dltech/laminator-nemo/sch/heater_dir_ctrl.png

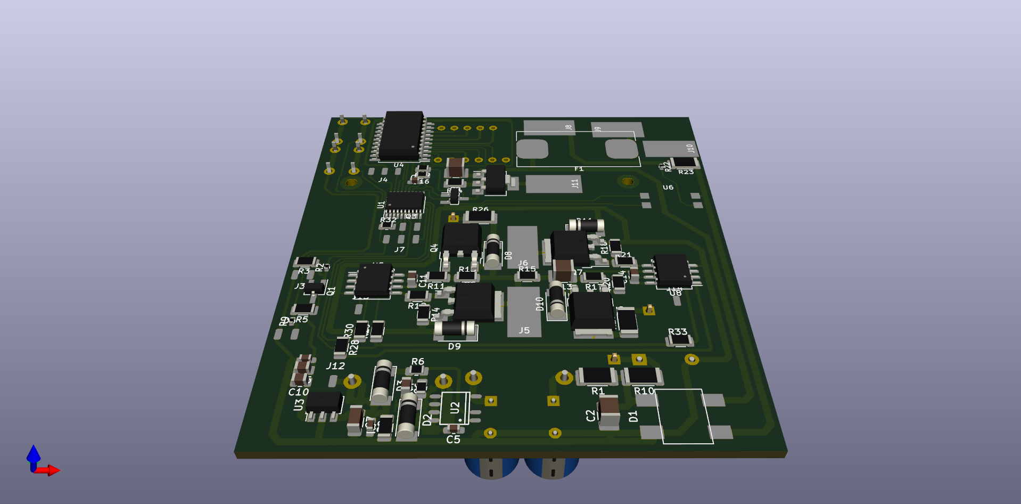
sch/heater_dir_ctrl.png
