dltech/laminator-nemo/README.md

# laminator-nemo
simple replacement board for office laminator with display, temperature and motor control.
