dltech/laminator-nemo/scenario.odt

Я как и многие другие электронщики не хочу себя ограничивать набором стандартных отладочных плат. И тут становится актуальным вопрос получения прототипов. В нашем веке совершенно любой прошаренный айтишник, может быть даже школьник, порывшись у себя в кармане найдет 20$ и закажет партию плат в китае. Да и вопросами они занимаются настолько опережающими время, что срок доставки конверта с платами в один два месяца почтой россии (почта китая отправляет пакет к нам обычно за неделю) для них не критичен. В то время как странноватые фрики вроде меня обсуждают на форумах вопрос, как бы так по культурнее перевести на иностранные языки типично любительский термин лазерно утюжная технология. Ну тут нет ничего плохого в том что ты оказался на днище технического прогресса, ведь всё можно прикрыть умным словом киберпанк, были бы хоть какие нибудь технологии. Причем мало кто знает что важно отличать киберпанк от посткиберпанка, в первом случае он самый, но еще средний, во втором уже полный. Ну тут не об этом, давайте подумаем, как же приблизить домашнее прототипирование ПП к заводскому? На заводах рисунок дорожек на плату переносится при помощи фоторезиста. А сам пленочный фоторезист плотно приклеивается при помощи валиков. Вот именно этот вопрос и будем решать в этом видео. Вот у меня есть сломанный ламинатор. По моему скромному мнению ему нужно заменить плату управления, да и родной двигатель утерян, но удачно подходят такие же от микроволновок. Наиболее полная плата управления должна включать термоконтроль, управление двигателем, замечать когда плата уже успела проехать и даже иметь какую то там индикацию для приличия. Вот так выглядит принципиальная схема платы, а вот так структурная. Термоконтроль это одно амперный планарный симистор ST и DS18B20й термодатчик. Управление двигателем мостом на двух амперных полевиках 2N60, ну вон те которые дайте кулечек транзисторов за 50, кто их произвел не знаю, но судя по маркировке это моторолла. Для того чтобы соединить их с контроллером пришлось поставить драйверы IR2103. Жаль что рассыпухой так просто этот вопрос не решишь, ровно как и не купишь по близости драйвер сразу на четыре транзистора. Раз TTL, два TTL и все как заверте.. Буферный повторитель перед симистором в моем случае это цифровой транзистор. Добавлять еще буферов, оптоизоляторов, стабилизаторов и согласователей уровней я не стал, потому что у меня все хорошо. Блок питания небезызвестный tinyswitch в бестрансформаторном варианте. Также добавлен еще один ключ для ультрафиолетовой лампы, как приедет добавлю, будет засвечивать строго по таймеру. Микроконтроллером по умолчанию для меня давно стал STM32, младшие их варианты одно время еще и стоили по 30р, почти как attiny. Сейчас сотка, ну терпимо, по прежнему сомневаюсь что кто то еще предложит дешевле Cortex M. Одни преимущества, прошивка по трем проводам, 48 мегагерц, 32 разряда (теперь можно спокойно объявлять int), жаль без плавающей точки, правда вот этому вот двух кнопочному оно зачем? Компилируется это все вместе со стандартными Си библиотеками чуть ли не полноценным gcc, как и под большую компьютеру, что очень удобно. Ну вот и мои 500 строчек, Ctrl-T, прописываем make, пиу, готово, оно прошилось. Отлаживал там же, ничуть не напрягло, ни трех проводность, ни терминальность. Теперь давайте проверять, вот тут у нас температуры разные, давайте подождем когда выровняет, а вот тут скорости можно переключать, а вот так вот удерживанием кнопки включается реверс тяги. И вот смотрите, то что произошло сейчас, это такой математический трюк. И вот меня например всегда интересовало, вот если в бутылку клейна продеть ленту мебиуса, то с какой стороны будет водка? Ну а теперь давайте что нибудь за ламинируем для примера, в общем штука рабочая. С момента когда я начал собирать эту поделку одного вечера до момента когда я её собрал прошло чуть меньше года, довольно долго, но ведь могло было бы быть еще дольше. Тут нужно сказать спасибо авторам вот этих библиотек и программных продуктов, благодаря им все удалось так просто.

libopencm3 (макросы, makefile, ld)

stlink utility

KiCad

GNU

В общем всем software freedom, ну а кому просто freedom.
