dltech/laminator-nemo/sch/schematic.png

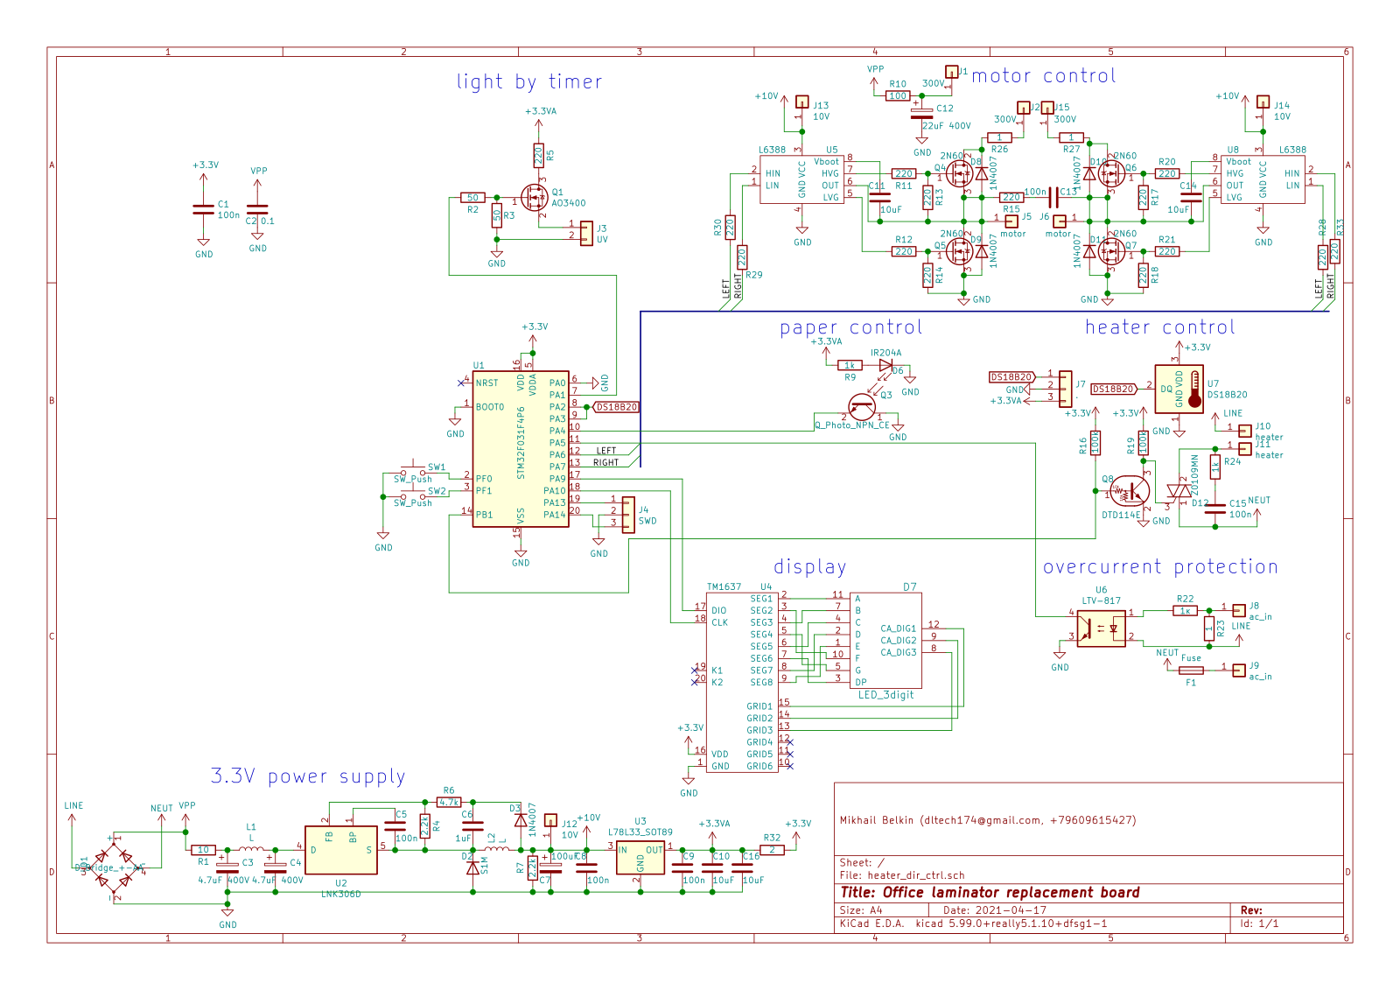
sch/schematic.png
