dltech/laminator-nemo/sch/heater_dir_ctrl/heater_dir_ctrl.kicad_pcb

## KiCad design sch/heater_dir_ctrl/heater_dir_ctrl.kicad_pcb (2022-04-14)

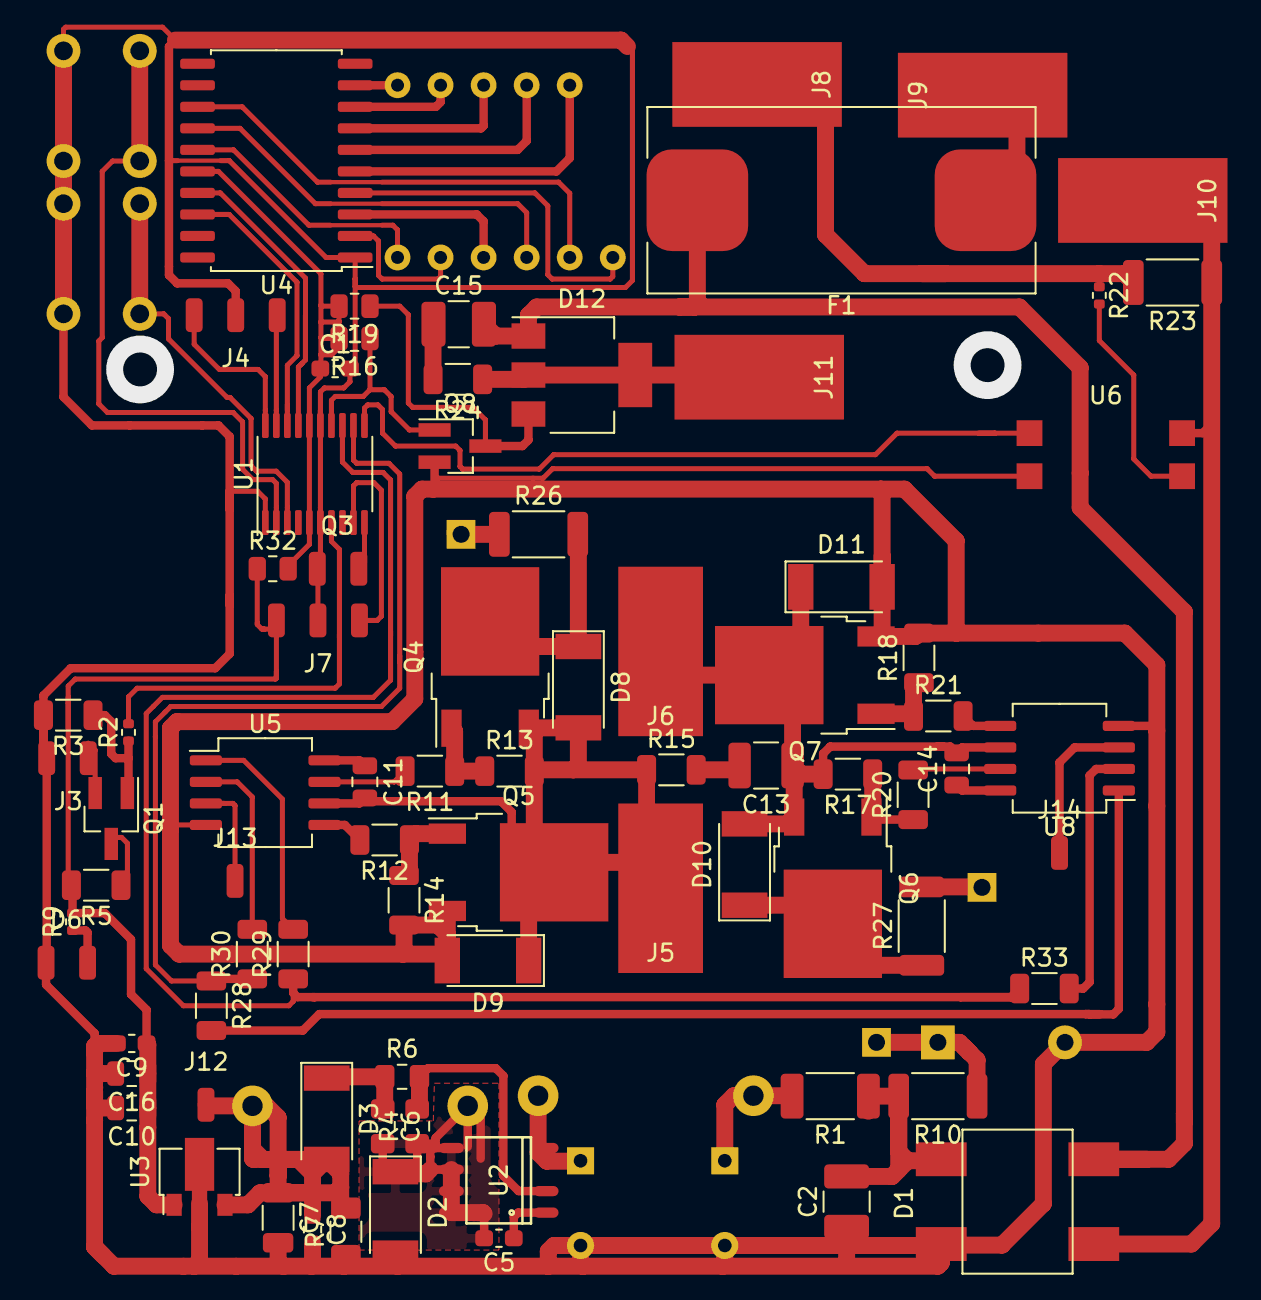
[picture p3: board heater_dir_ctrl.kicad_pcb from above]

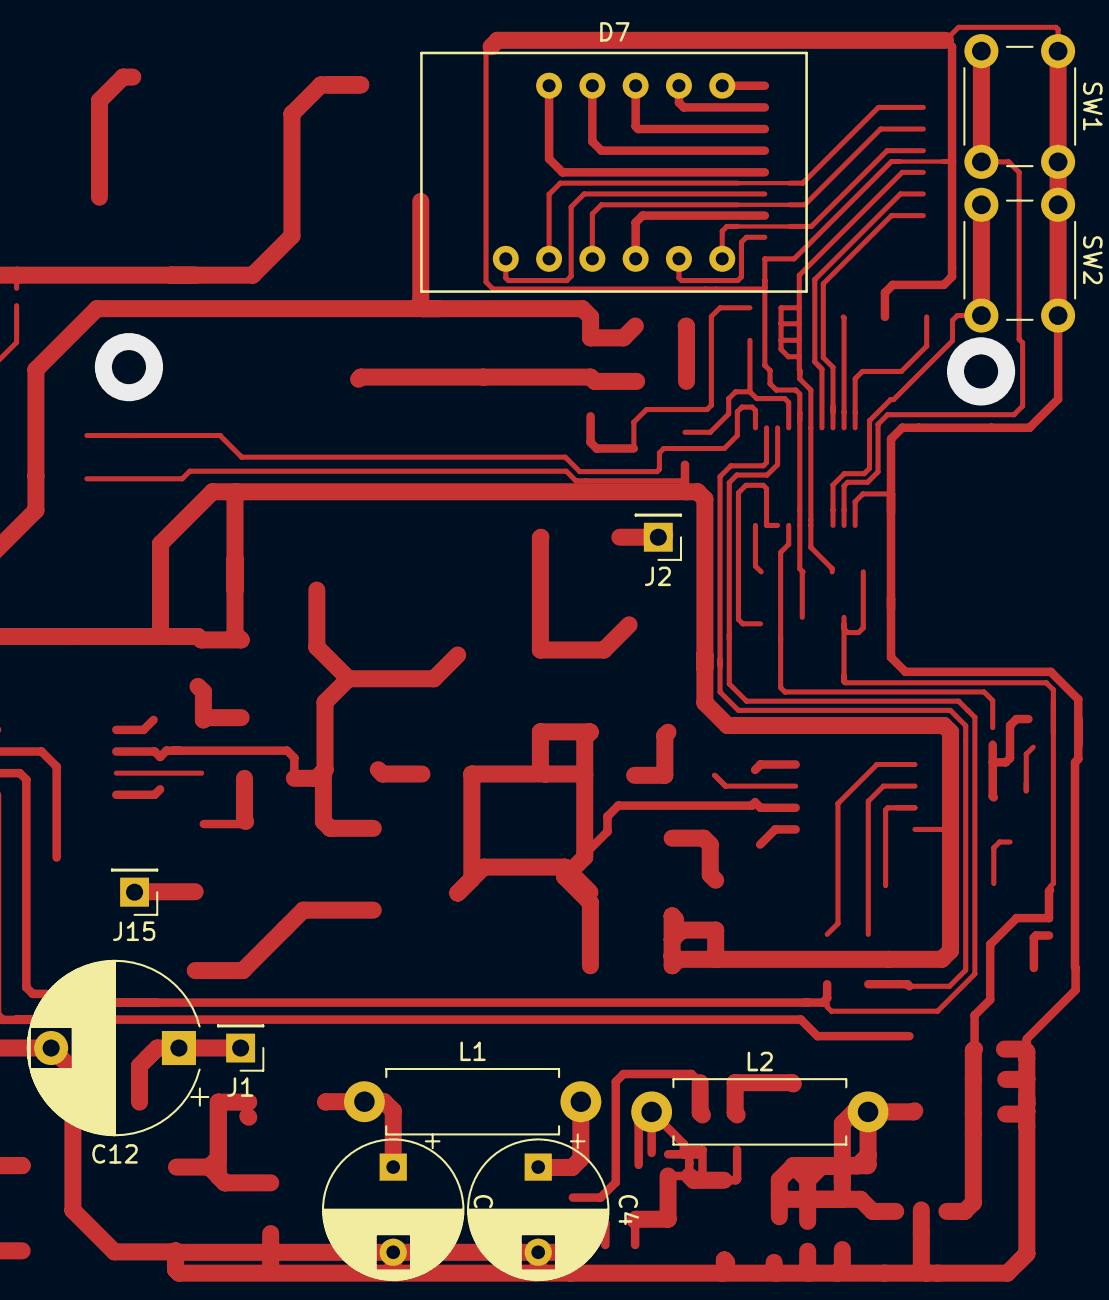
[picture p4: board heater_dir_ctrl.kicad_pcb from below]

Board: 2 copper layers, 90 parts (11 on the bottom side), 69 nets.

Parts:
C1, C5, C8, C9: 100n; C_0603_1608Metric_Pad1.05x0.95mm_HandSolder
C2: 0.1; C_1210_3225Metric_Pad1.42x2.65mm_HandSolder
C3, C4: 4.7uF 400V; CP_Radial_D8.0mm_P5.00mm
C6: 1uF; C_0805_2012Metric_Pad1.15x1.40mm_HandSolder
C7: 100uF; C_1206_3216Metric
C10, C11, C14, C16: 10uF; C_0805_2012Metric
C12: 22uF 400V; CP_Radial_D10.0mm_P7.50mm
C13: 100n; C_1210_3225Metric_Pad1.33x2.70mm_HandSolder
C15: 100n; C_1210_3225Metric_Pad1.42x2.65mm_HandSolder
D1: D_Bridge_+-AA; DB-1S
D2: S1M; D_MELF
D3, D8, D9, D10, D11: 1N4007; D_MELF
D6: IR204A; 2WIRE_PADS
D7: LED_3digit; FYT-3631_nonc
D12: Z0109MN; SOT-223
F1: Fuse; Fuseholder_Cylinder-5x20mm_Schurter_OGN-SMD_Horizontal_Open
J1, J2, J15: 300V; PinHeader_1x01_P2.54mm_Vertical
J3: UV; 2WIRE_PADS
J4: SWD; 3WIRE_PADS
J5, J6: motor; SolderWirePad_1x01_SMD_5x10mm
J7: .; 3WIRE_PADS
J8, J9: ac_in; SolderWirePad_1x01_SMD_5x10mm
J10, J11: heater; SolderWirePad_1x01_SMD_5x10mm
J12, J13, J14: 10V; SolderWirePad_1x01_SMD_1x2mm
L1, L2: L; R_Axial_DIN0411_L9.9mm_D3.6mm_P12.70mm_Horizontal
Q1: AO3400; SOT-23_Handsoldering
Q3: Q_Photo_NPN_CE; 2WIRE_PADS
Q4, Q5, Q6, Q7: 2N60; TO-252-2
Q8: DTD114E; SOT-23_Handsoldering
R1: 10; R_2010_5025Metric
R2: 50; R_0402_1005Metric
R3: 50; R_1206_3216Metric
R4: 2.2k; R_0805_2012Metric_Pad1.15x1.40mm_HandSolder
R5, R11, R12, R13, R14, R15, R17, R18, R20, R21, R28, R29, R30, R33: 220; R_1206_3216Metric
R6: 4.7k; R_0805_2012Metric_Pad1.15x1.40mm_HandSolder
R7: 2.2k; R_1206_3216Metric
R9: 1k; R_0402_1005Metric
R10: 100; R_2010_5025Metric
R16, R19: 100k; R_0805_2012Metric
R22: 1к; R_0402_1005Metric
R23, R26, R27: 1; R_2010_5025Metric
R24: 1k; R_1206_3216Metric
R32: 2; R_0805_2012Metric
SW1, SW2: SW_Push; SW_PUSH_6mm
U1: STM32F031F4P6; TSSOP-20_4.4x6.5mm_P0.65mm
U2: LNK306D; SO-8C
U3: L78L33_SOT89; SOT-89-3
U4: TM1637; SOIC-20W_7.5x12.8mm_P1.27mm
U5, U8: L6388; SO-8_5.3x6.2mm_P1.27mm
U6: LTV-817; LTV817

Connections:
+3.3VA: C9.1, C10.1, C16.1, J7.3, R5.2, R9.2, R32.1, U3.1
+3V3: C1.1, R16.2, R19.2, R32.2, U1.5, U1.16, U4.16
+10V: C7.1, C8.1, D3.2, J12.1, J13.1, J14.1, L2.2, R7.2, U3.3, U5.3, U8.3
/LEFT: R28.1, R30.1, U1.12
/RIGHT: R29.1, R33.1, U1.13
DS18B20: J7.1, U1.8, U1.9
GND: C1.2, C2.1, C3.2, C4.2, C7.2, C8.2, C9.2, C10.2, C12.2, C16.2, D1.2, D2.2, D6.1, D9.2, D11.2, J3.2, J4.2, J7.2, Q3.1, Q5.3, Q7.3, Q8.2, R3.2, R7.1, R14.2, R18.2, SW1.1, SW2.1, U1.1, U1.6, U1.15, U3.2, U4.1, U5.4, U6.3, U8.4
LINE: D1.3, J10.1, R23.1, U6.2
NEUT: C15.2, D1.4, D12.1, F1.2
unnamed: C3.1, L1.1, R1.2
unnamed: C4.1, L1.2, U2.4
unnamed: C5.1, U2.1
unnamed: C5.2, C6.2, D2.1, L2.1, R4.1, U2.5, U2.6, U2.7, U2.8
unnamed: C6.1, D3.1, R6.1
unnamed: C11.1, U5.8
unnamed: C11.2, D8.2, D9.1, J5.1, Q4.3, Q5.2, R13.2, R15.1, U5.6
unnamed: C12.1, J1.1, R10.1
unnamed: C13.1, C14.2, D10.2, D11.1, J6.1, Q6.3, Q7.2, R17.2, U8.6
unnamed: C13.2, R15.2
unnamed: C14.1, U8.8
unnamed: C15.1, R24.2
unnamed: D6.2, R9.1
unnamed: D7.1, U4.9
unnamed: D7.2, U4.8
unnamed: D7.3, U4.7
unnamed: D7.4, U4.6
unnamed: D7.5, U4.5
unnamed: D7.7, U4.4
unnamed: D7.8, U4.13
unnamed: D7.9, U4.14
unnamed: D7.10, U4.3
unnamed: D7.11, U4.2
unnamed: D7.12, U4.15
unnamed: D8.1, Q4.2, R26.2
unnamed: D10.1, Q6.2, R27.1
unnamed: D12.2, D12.4, J11.1, R24.1
unnamed: D12.3, Q8.3, R19.1
unnamed: F1.1, J9.1
unnamed: J2.1, R26.1
unnamed: J3.1, Q1.2
unnamed: J4.1, U1.19
unnamed: J4.3, U1.20
unnamed: J8.1, R22.1, R23.2
unnamed: J15.1, R27.2
unnamed: Q1.1, R2.1, R3.1
unnamed: Q1.3, R5.1
unnamed: Q3.2, U1.10
unnamed: Q4.1, R11.1, R13.1
unnamed: Q5.1, R12.1, R14.1
unnamed: Q6.1, R17.1, R20.1
unnamed: Q7.1, R18.1, R21.1
unnamed: Q8.1, R16.1, U1.14
unnamed: R2.2, U1.7
unnamed: R4.2, R6.2, U2.2
unnamed: R11.2, U5.7
unnamed: R12.2, U5.5
unnamed: R20.2, U8.7
unnamed: R21.2, U8.5
unnamed: R22.2, U6.1
unnamed: R28.2, U8.1
unnamed: R29.2, U5.1
unnamed: R30.2, U5.2
unnamed: R33.2, U8.2
unnamed: SW1.2, U1.2
unnamed: SW2.2, U1.3
unnamed: U1.11, U6.4
unnamed: U1.17, U4.17
unnamed: U1.18, U4.18
VPP: C2.2, D1.1, R1.1, R10.2
