dltech/laminator-nemo/(commit log)

2020-12-02 digits are working, sinus output too
    [heater_dir_ctrl.kicad_pcb, heater_dir_ctrl.sch, new.kicad_pcb]
2021-04-07 add ds18b20 hardware
    [heater_dir_ctrl.sch]
2021-04-13 sch w new transistors
    [heater_dir_ctrl.kicad_pcb, heater_dir_ctrl.sch]
2021-04-16 PCB with new transistors
    [heater_dir_ctrl.kicad_pcb, heater_dir_ctrl.sch, new.kicad_pcb]
2021-04-17 didn't fit
    [heater_dir_ctrl.kicad_pcb, heater_dir_ctrl.sch]
2021-05-07 upd scenario
    [heater_dir_ctrl.sch]
2021-05-10 board ok
    [heater_dir_ctrl.kicad_pcb, heater_dir_ctrl.sch]
2021-05-22 some corrections
    [heater_dir_ctrl.sch]
2021-05-23 program ds18b20, usart based fails after 60C
    [main.c]
2021-05-27 78l instead of 1117, synchronized pwm ok, not tested
    [heater_dir_ctrl.kicad_pcb, heater_dir_ctrl.sch]
2022-04-14 new drivers
    [heater_dir_ctrl.kicad_pcb, heater_dir_ctrl.sch]
